ynain/ECE-477/src/piCode/cameratest/stream_mockup.png

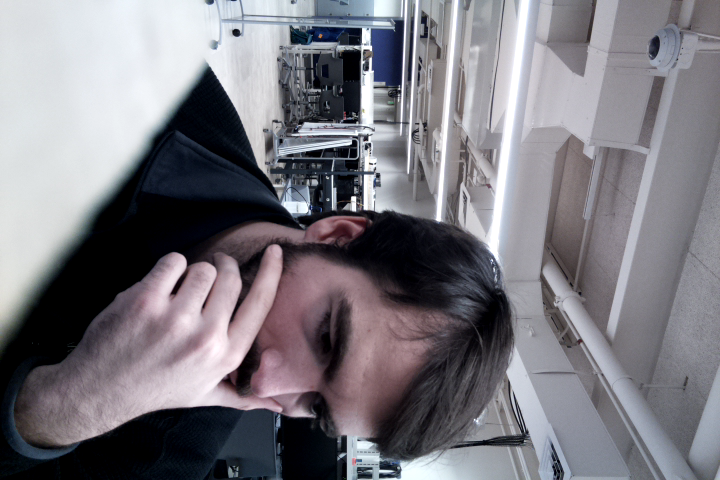
src/piCode/cameratest/stream_mockup.png
