ynain/ECE-477/src/piCode/streamwrite/frames/README.md

This is a dump location for frames, they will all be ignored (ideally)
