ynain/ECE-477/EAGLE/projects/477PCBv1/PCB1.png

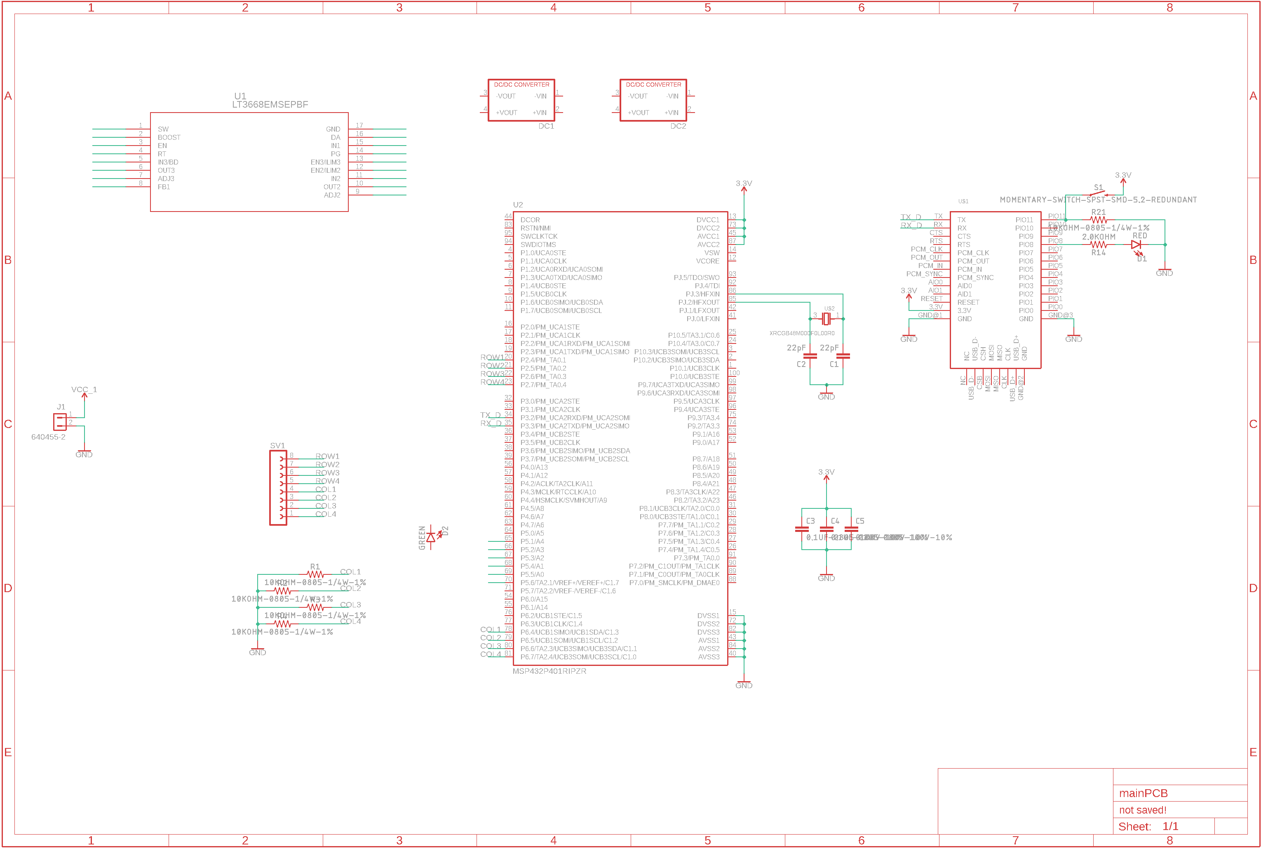
EAGLE/projects/477PCBv1/PCB1.png
