ynain/ECE-477/EAGLE/projects/477PCBv1/PCBv2.png

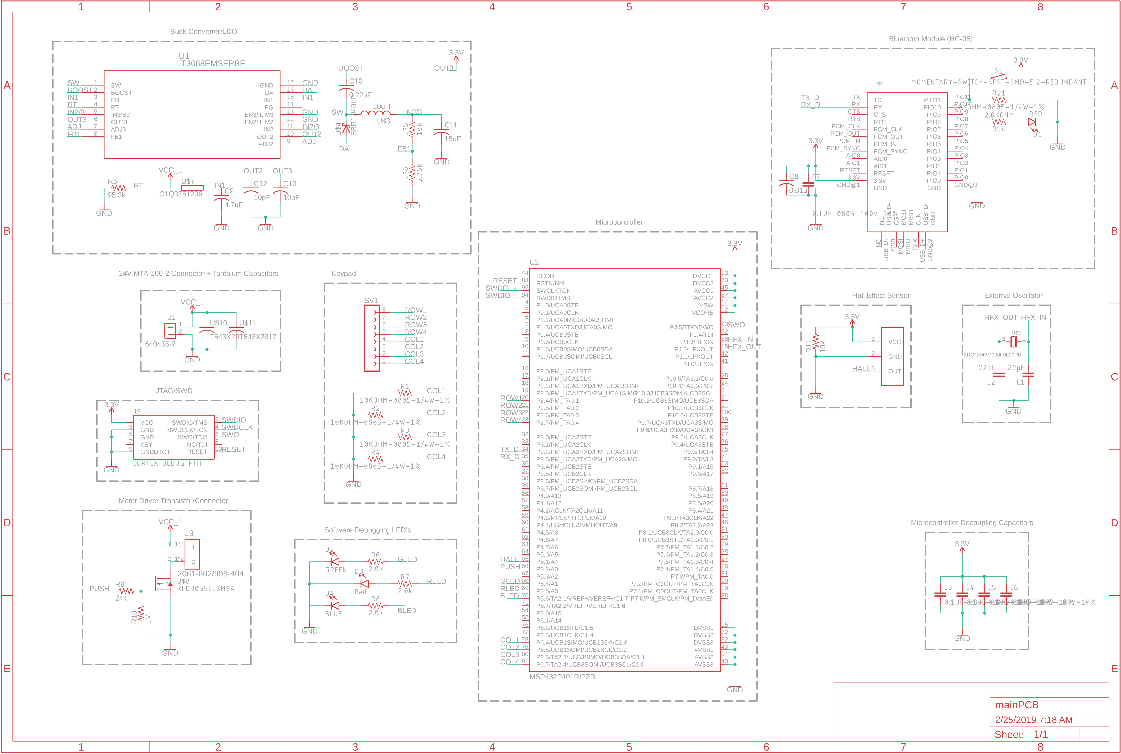
EAGLE/projects/477PCBv1/PCBv2.png
