ynain/ECE-477/EAGLE/projects/477PCBv1/mainPCB.brd

## EAGLE design EAGLE/projects/477PCBv1/mainPCB.brd (2019-03-28)

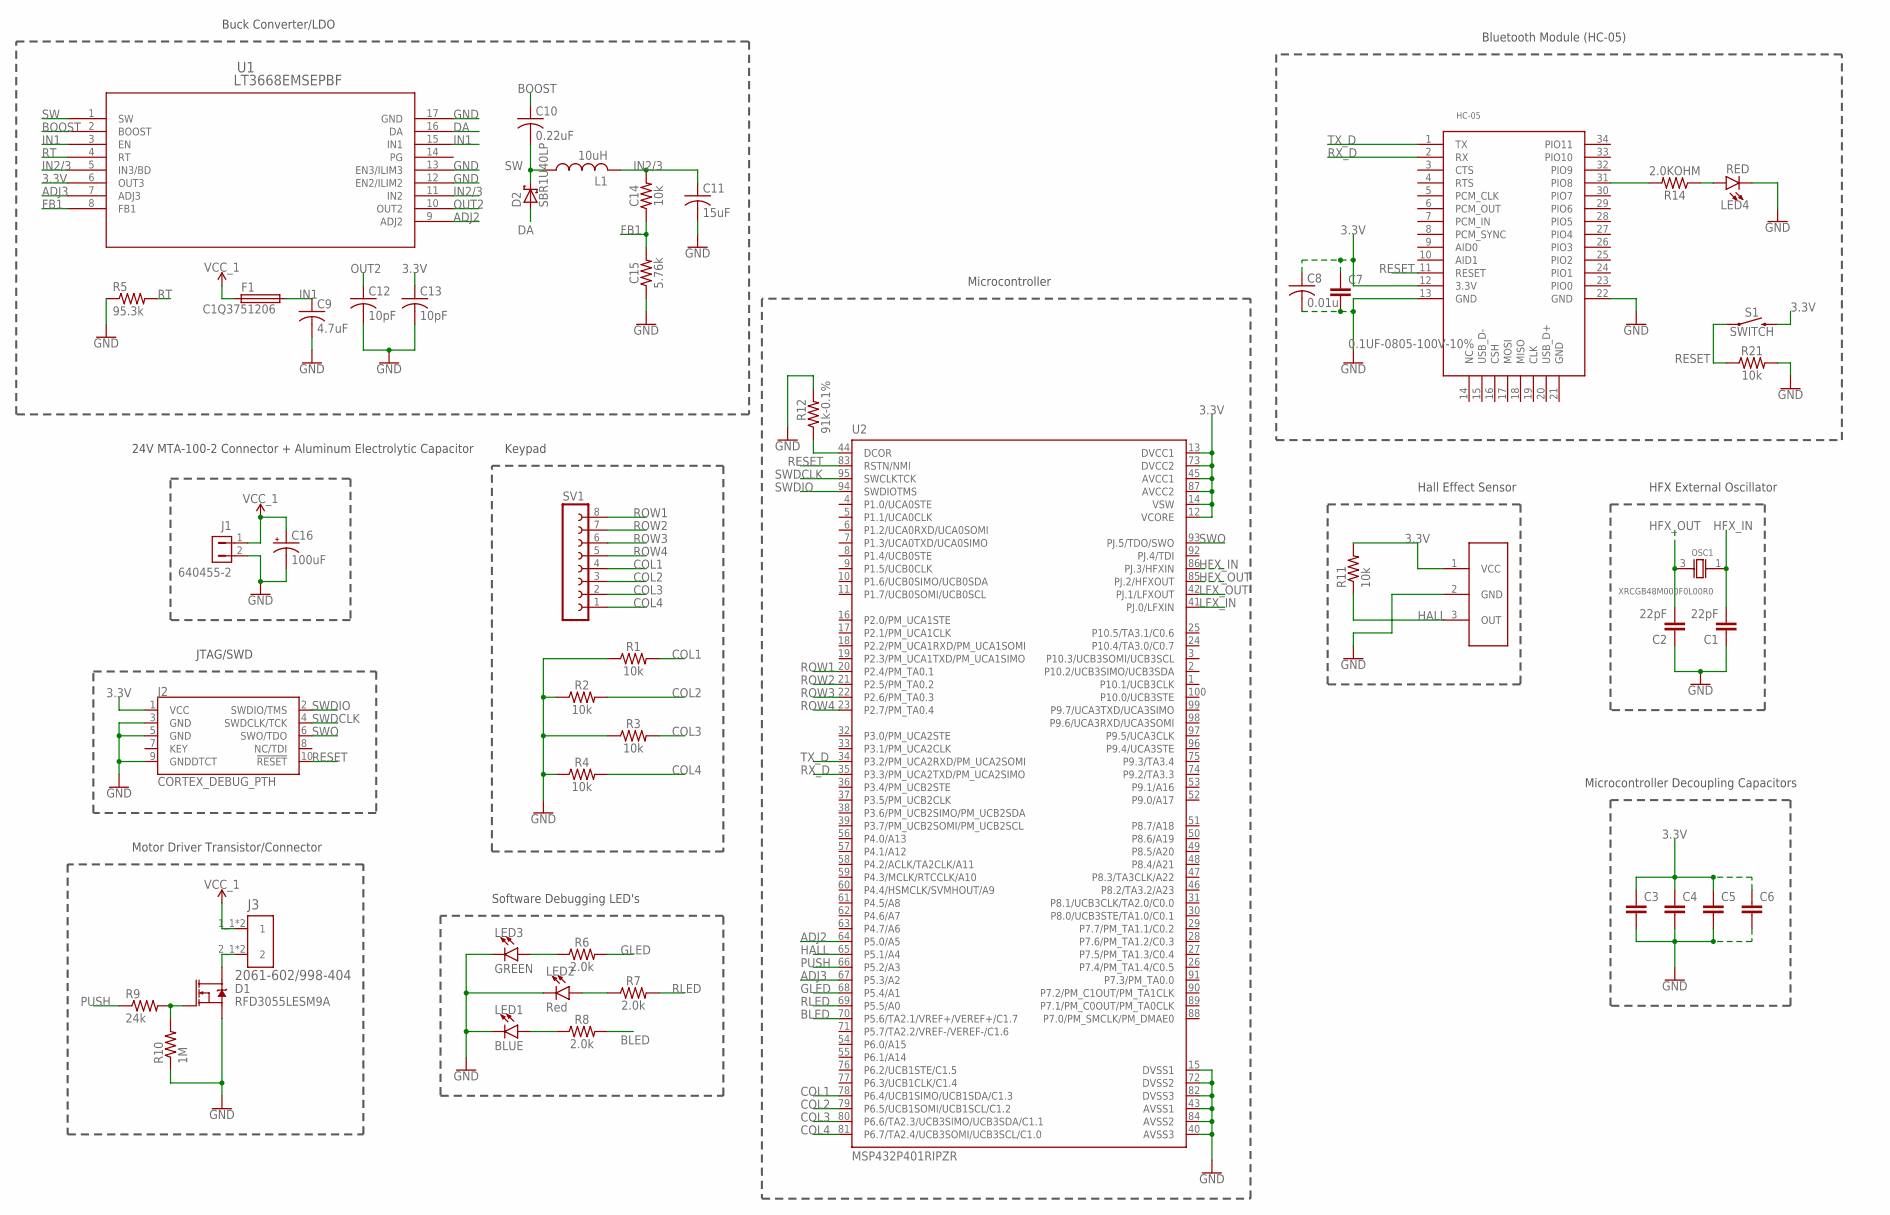
[picture p4: schematic mainPCB.sch, Microcontroller + Keypad + Motor Driver]

Parts:
C1, C2: 22pF; 0603
C3, C4, C5, C6, C7: 0.1UF-0805-100V-10%; 0805
C8: 0.01u; C0805
C9: 4.7uF; C0805
C10: 0.22uF; C0805
C11: 15uF; C0805
C12, C13: 10pF; C0805
C14: 10k; R0805
C15: 5.76k; R0805
C16: 100uF; PANASONIC_D
D1: RFD3055LESM9A; DPAK229P990X239-4N
D2: SBR1U40LP; 3-XDFN
F1: C1Q3751206; C1206
H1: HES; SIP3-UA
HC-05: HC-05; XCVR_HC-05
J1: 640455-2; 2-PIN_CONNECTOR
J2: CORTEX_DEBUG_PTH; 2X5-PTH-1.27MM
J3: 2061-602/998-404; WAGO_2061-602/998-404
L1: 10uH; L3225M
LED1: BLUE; LED-0603
LED2: Red; LED-0603
LED3: GREEN; LED-0603
LED4: RED; LED-0603
OSC1: XRCGB48M000F0L00R0; XTAL_XRCGB24M000F0L00R0
R1, R2, R3, R4, R21: 10k; 0805
R5: 95.3k; R0805
R6, R7, R8: 2.0k; 0603
R9: 24k; R0805
R10: 1M; R0805
R11: 10k; R0805
R12: 91k-0.1%; R0805
R14: 2.0KOHM; 0805
S1: SWITCH; TACTILE_SWITCH_SMD_5.2MM
SV1: FE08-1; FE08
U1: LT3668EMSEPBF; MSOP-16_MSE
U2: MSP432P401RIPZR; QFP50P1600X1600X160-100N

Connections:
3.3V: C3.1, C4.1, C5.1, C6.1, C7.1, C8.1, C13.1, H1.1 (VCC), HC-05.12 (3.3V), J2.1 (VCC), R11.2, S1.3 (2), S1.4 (2), U1.6 (OUT3), U2.12 (VCORE), U2.13 (DVCC1), U2.14 (VSW), U2.45 (AVCC1), U2.73 (DVCC2), U2.87 (AVCC2)
ADJ2: U1.9 (ADJ2), U2.64 (P5.0/A5)
ADJ3: U1.7 (ADJ3), U2.67 (P5.3/A2)
BLED: R8.2, U2.70 (P5.6/TA2.1/VREF+/VEREF+/C1.7)
BOOST: C10.1, U1.2 (BOOST)
COL1: R1.2, SV1.4, U2.78 (P6.4/UCB1SIMO/UCB1SDA/C1.3)
COL2: R2.2, SV1.3, U2.79 (P6.5/UCB1SOMI/UCB1SCL/C1.2)
COL3: R3.2, SV1.2, U2.80 (P6.6/TA2.3/UCB3SIMO/UCB3SDA/C1.1)
COL4: R4.2, SV1.1, U2.81 (P6.7/TA2.4/UCB3SOMI/UCB3SCL/C1.0)
DA: D2.1 (A), U1.16 (DA)
FB1: C14.1, C15.2, U1.8 (FB1)
GLED: R6.2, U2.68 (P5.4/A1)
GND: C1.1, C2.1, C3.2, C4.2, C5.2, C6.2, C7.2, C8.2, C9.2, C11.2, C12.2, C13.2, C15.1, C16.-, D1.3 (S), H1.2 (GND), HC-05.13 (GND), HC-05.22 (GND), J1.2, J2.3 (GND), J2.5 (GND), J2.9 (GNDDTCT), LED1.C, LED2.C, LED3.C, LED4.C, R1.1, R2.1, R3.1, R4.1, R5.1, R10.1, R12.2, R21.2, U1.12 (EN2/ILIM2), U1.13 (EN3/ILIM3), U1.17 (GND), U2.15 (DVSS1), U2.40 (AVSS3), U2.43 (AVSS1), U2.72 (DVSS2), U2.82 (DVSS3), U2.84 (AVSS2)
HALL: H1.3 (OUT), R11.1, U2.65 (P5.1/A4)
HFX_IN: C1.2, OSC1.1, U2.86 (PJ.3/HFXIN)
HFX_OUT: C2.2, OSC1.3 (2), U2.85 (PJ.2/HFXOUT)
IN1: C9.1, F1.2, U1.3 (EN), U1.15 (IN1)
IN2/3: C11.1, C14.2, L1.2, U1.5 (IN3/BD), U1.11 (IN2)
LFX_IN: U2.41 (PJ.0/LFXIN)
LFX_OUT: U2.42 (PJ.1/LFXOUT)
unnamed: D1.1 (G), R9.2, R10.2
unnamed: D1.4 (D), J3.2_1 (2), J3.2_2 (2)
unnamed: LED4.A, R14.1
unnamed: LED3.A, R6.1
unnamed: LED2.A, R7.1
unnamed: LED1.A, R8.1
unnamed: R12.1, U2.44 (DCOR)
unnamed: HC-05.31 (PIO8), R14.2
OUT2: C12.1, U1.10 (OUT2)
PUSH: R9.1, U2.66 (P5.2/A3)
RESET: HC-05.11 (RESET), J2.10 (!RESET), R21.1, S1.1, S1.2 (1), U2.83 (RSTN/NMI)
RLED: R7.2, U2.69 (P5.5/A0)
ROW1: SV1.8, U2.20 (P2.4/PM_TA0.1)
ROW2: SV1.7, U2.21 (P2.5/PM_TA0.2)
ROW3: SV1.6, U2.22 (P2.6/PM_TA0.3)
ROW4: SV1.5, U2.23 (P2.7/PM_TA0.4)
RT: R5.2, U1.4 (RT)
RX_D: HC-05.2 (RX), U2.35 (P3.3/PM_UCA2TXD/PM_UCA2SIMO)
SW: C10.2, D2.2 (C), D2.3 (C), L1.1, U1.1 (SW)
SWDCLK: J2.4 (SWDCLK/TCK), U2.95 (SWCLKTCK)
SWDIO: J2.2 (SWDIO/TMS), U2.94 (SWDIOTMS)
SWO: J2.6 (SWO/TDO), U2.93 (PJ.5/TDO/SWO)
TX_D: HC-05.1 (TX), U2.34 (P3.2/PM_UCA2RXD/PM_UCA2SOMI)
VCC_1: C16.+, F1.1, J1.1, J3.1_1 (1), J3.1_2 (1)

Notes on the sheet:
24V MTA-100-2 Connector + Aluminum Electrolytic Capacitor
Keypad
Software Debugging LED's
Microcontroller
HFX External Oscillator
Microcontroller Decoupling Capacitors
JTAG/SWD
Buck Converter/LDO
Motor Driver Transistor/Connector
Hall Effect Sensor
Bluetooth Module (HC-05)

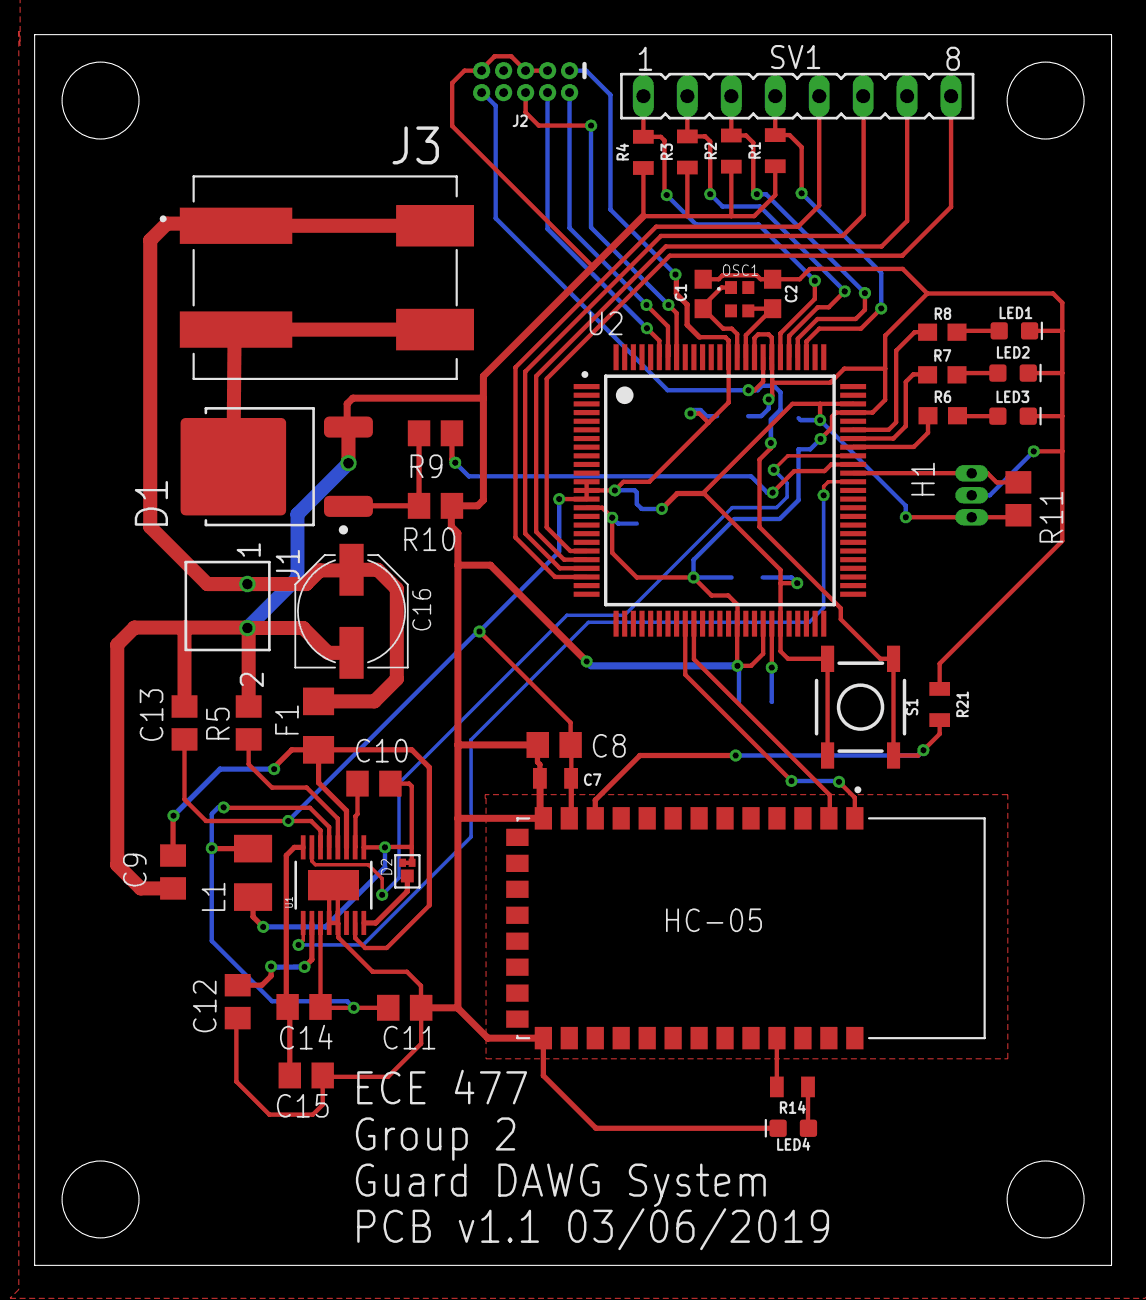
[picture p5: board mainPCB.brd from above]

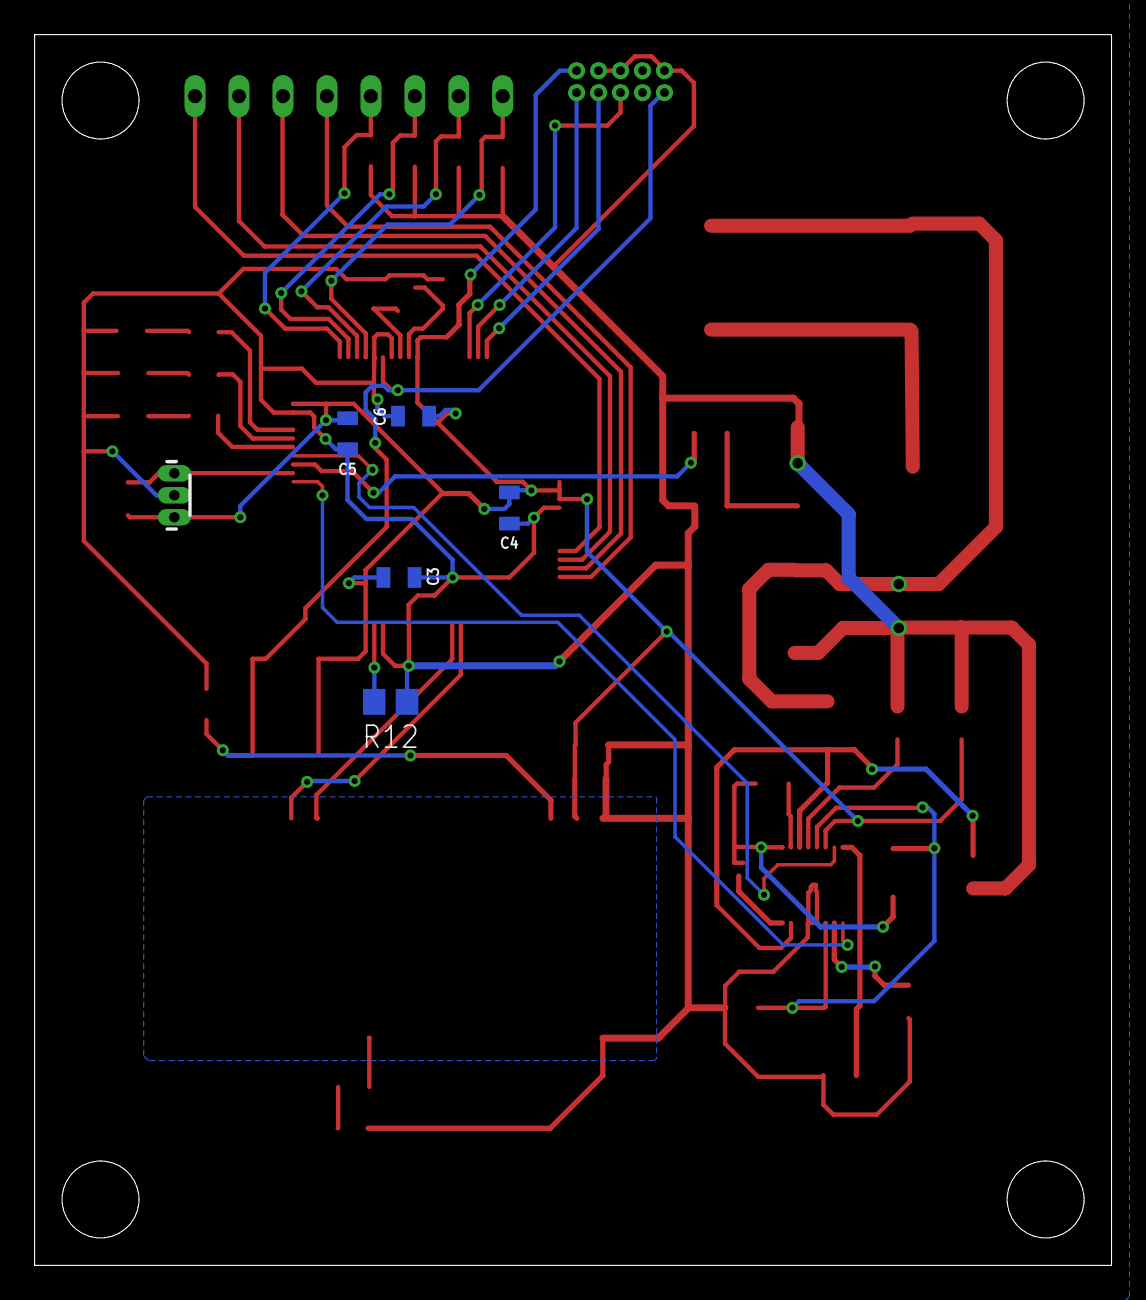
[picture p6: board mainPCB.brd from below]

Board: 2 copper layers, 62.2 x 71.1 mm, 48 parts (6 on the bottom side), 42 nets.
