ynain/ECE-477/msp432/Hardware/CS_Driver.c

#include <Headers/CS_Driver.h>

void CS_Init(void)
{
    //![Simple CS Config]
    /* Configuring pins for peripheral/crystal usage and LED for output */
    MAP_GPIO_setAsPeripheralModuleFunctionOutputPin(GPIO_PORT_PJ,
            GPIO_PIN3 | GPIO_PIN2, GPIO_PRIMARY_MODULE_FUNCTION);
    MAP_GPIO_setAsOutputPin(GPIO_PORT_P1, GPIO_PIN0);

    /* Just in case the user wants to use the getACLK, getMCLK, etc. functions,
     * let's set the clock frequency in the code.
     */
    CS_setExternalClockSourceFrequency(32000, 48000000);
    PCM_setCoreVoltageLevel(PCM_VCORE1);
    FlashCtl_setWaitState(FLASH_BANK0, 2);
    FlashCtl_setWaitState(FLASH_BANK1, 2);

    CS_startHFXT(0);
    //CS_setDCOCenteredFrequency(CS_DCO_FREQUENCY_24);
    CS_initClockSignal(CS_MCLK, CS_HFXTCLK_SELECT, CS_CLOCK_DIVIDER_2);
    CS_initClockSignal(CS_SMCLK, CS_HFXTCLK_SELECT, CS_CLOCK_DIVIDER_4);
}
