ynain/ECE-477/(commit log)

2019-01-17 Python code for early camera functionality
2019-01-26 Tensorflow is bae (Current raspbian version, Python 3.5)
2019-01-27 Got streaming working from example, threading may be needed for 4fps
2019-01-27 testing threading for speed increase of the process
2019-01-27 This file status setting for thread_client.py got 13 images to send in 3 seconds for 4.14fps, and 9 images in 2s for 4.05 fps. Likely the setting we'll use if we want to hit 4fps
2019-01-27 editing to let the computer be the client... and understanding socket connections meanwhile
2019-01-28 Giving credit to the source enabling wifi hotspotting for the Pi. And also ignoring frames loaded by this script.
2019-02-03 Computer is the server, pi is the client, process flow makes more sense that way
2019-02-03 Faces are able to be piped in and recognized, no faces in frame is caught, and FaceNet automatically picks out the largest face in the image? Need to suppress the terminal output if we're going to co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
2019-02-08 Added check in case npz file isn't present, also fixing frame/face variable error for the 16th time I swear, don't know why it's persisting
2019-02-19 Getting sockets to work... Flush. Everything.
2019-02-19 Computer end of getting socket to work
2019-03-06 Got the application working with the current Micro 'state machine'
2019-03-22 Saving current msp432 status, with STATE flag for HC-05 working
2019-03-22 Weird interrupt issue
2019-03-28 PCBv1
    Original PCBv1 schematic/layout/gerbers
    [mainPCB.brd, mainPCB.csv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]
2019-03-28 Revert to "Not sending signals if not connected"
    This reverts commit 06c78371b09302636f16c74713acbd3d6e6c9776.
    [main.c]
2019-03-28 Fixed some things
    [mainPCB.brd, mainPCB.csv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]
2019-03-29 fixing Ian's mess up
    [CS_Driver.c, HC05_driver.c, KEYPAD_driver.c, MSPIO.c]
2019-04-01 Builds now, should be roughly fixed...?
    [CS_Driver.c, HC05_driver.c, KEYPAD_driver.c, MSPIO.c]
2019-04-01 keypad driver is alive.
2019-04-01 added some password logic, still buggy
    [HC05_driver.c, main.c]
2019-04-15 keypad works!
    [CS_Driver.obj, HC05_driver.obj, KEYPAD_driver.obj, LED_driver.obj, Lock_handler.obj, MSPIO.obj, TIMER_handle.obj, UART_Driver.obj]
2019-04-19 First trial for getting the App PCB-run, and not laptop run
2019-04-23 print statements
